chaBotsMX/chaBots-NERV-WRO-Future-Engineers-2025/v-photos/national/v-bottom.jpeg

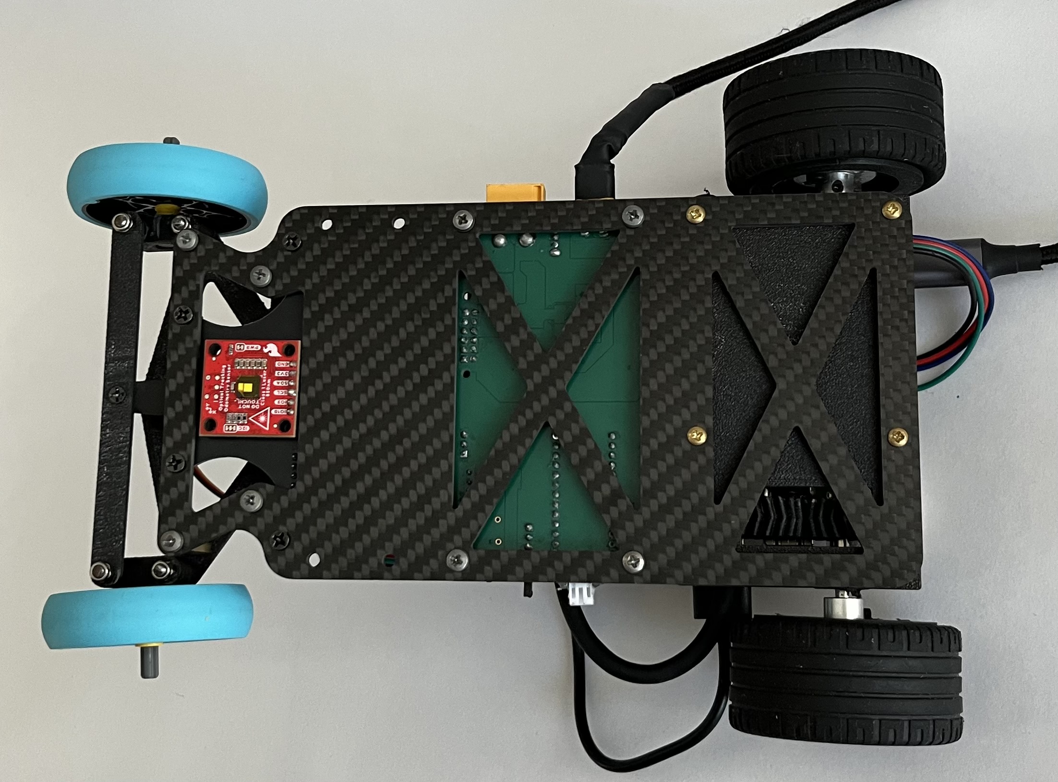
v-photos/national/v-bottom.jpeg
