chaBotsMX/chaBots-NERV-WRO-Future-Engineers-2025/v-photos/national/v-top.jpeg

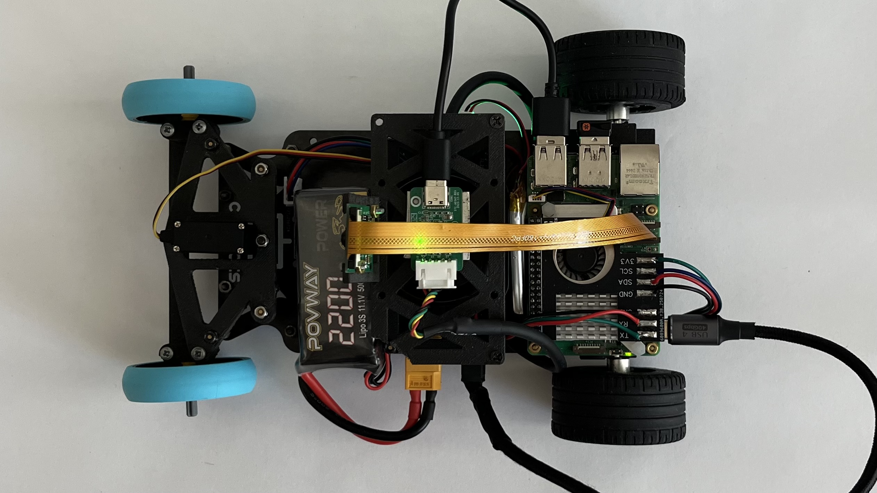
v-photos/national/v-top.jpeg
