chaBotsMX/chaBots-NERV-WRO-Future-Engineers-2025/v-photos/regional/back-view.jpeg

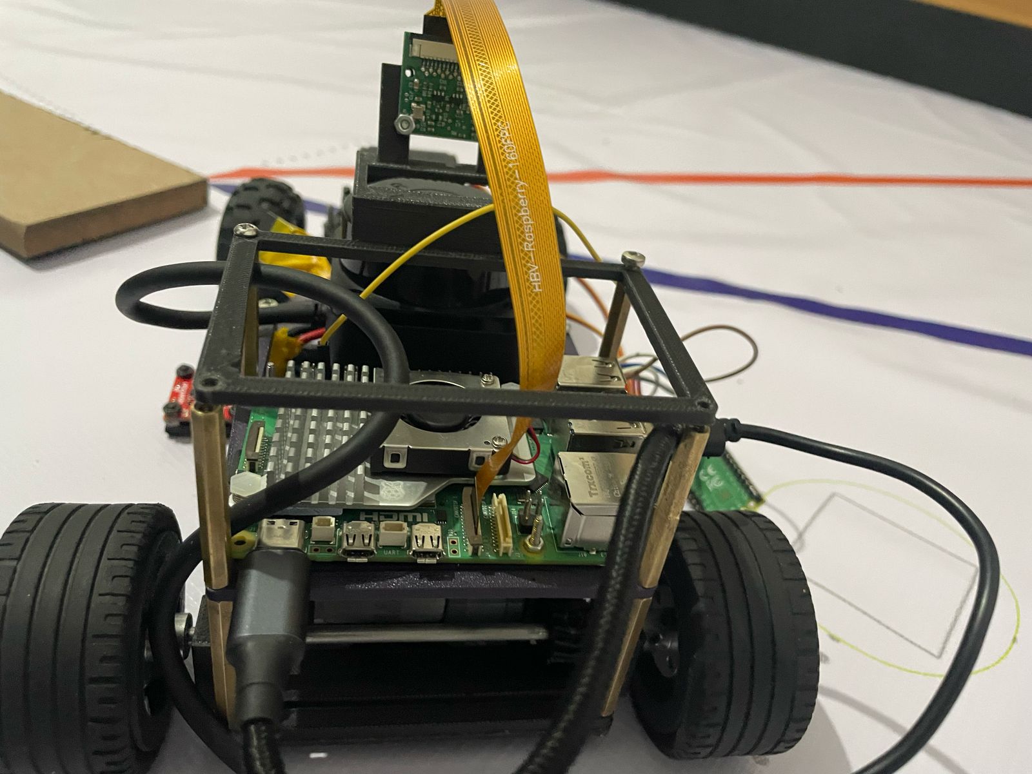
v-photos/regional/back-view.jpeg
