chaBotsMX/chaBots-NERV-WRO-Future-Engineers-2025/v-photos/regional/front-view.jpeg

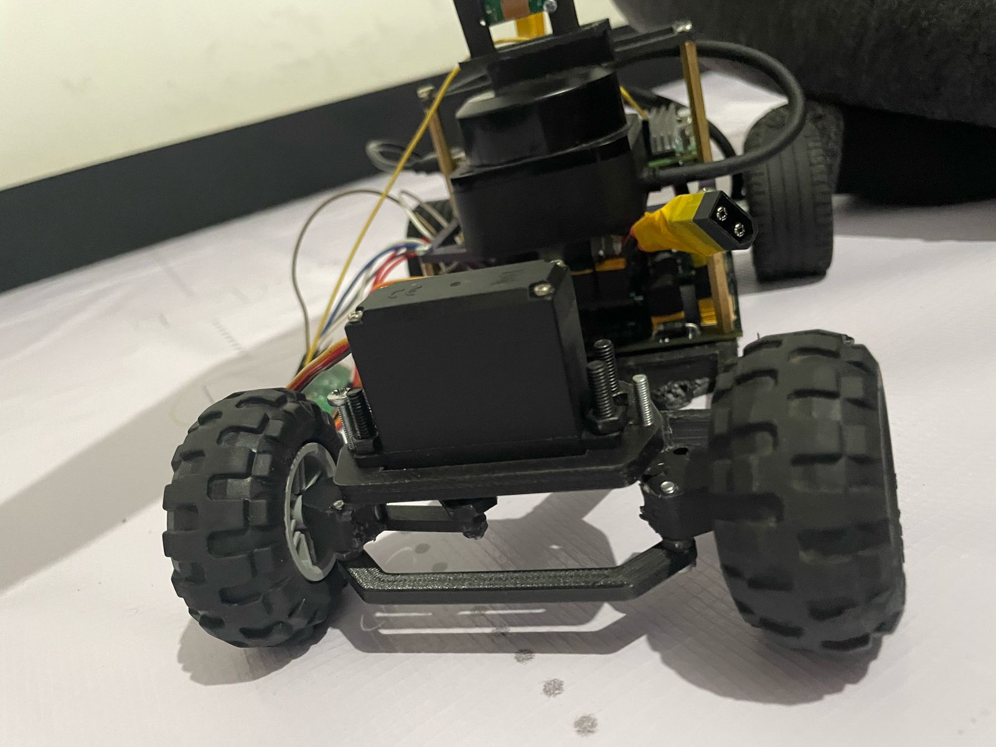
v-photos/regional/front-view.jpeg
