chaBotsMX/chaBots-NERV-WRO-Future-Engineers-2025/v-photos/regional/left-view.jpeg

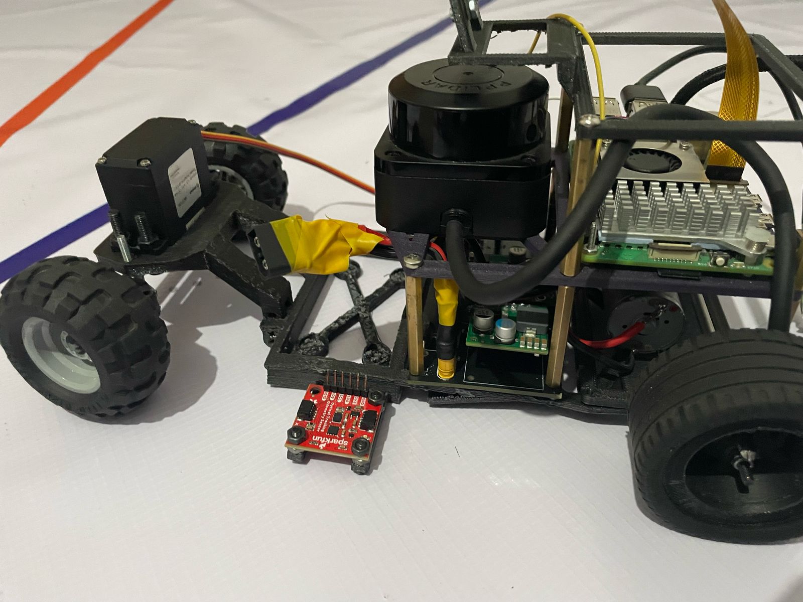
v-photos/regional/left-view.jpeg
