chaBotsMX/chaBots-NERV-WRO-Future-Engineers-2025/v-photos/regional/right-view.jpeg

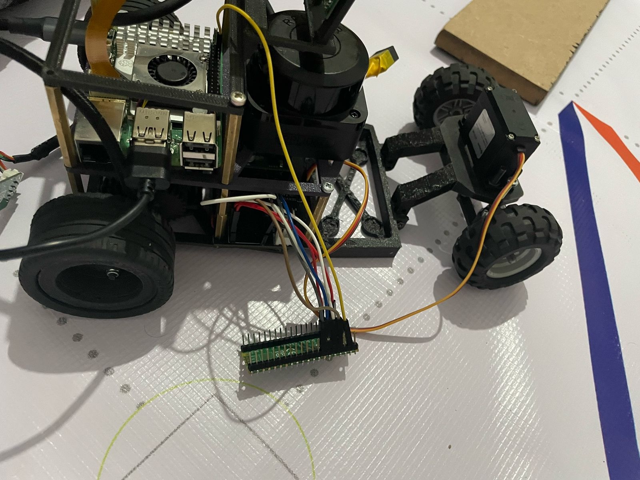
v-photos/regional/right-view.jpeg
