chaBotsMX/chaBots-NERV-WRO-Future-Engineers-2025/v-photos/regional/top-view.jpeg

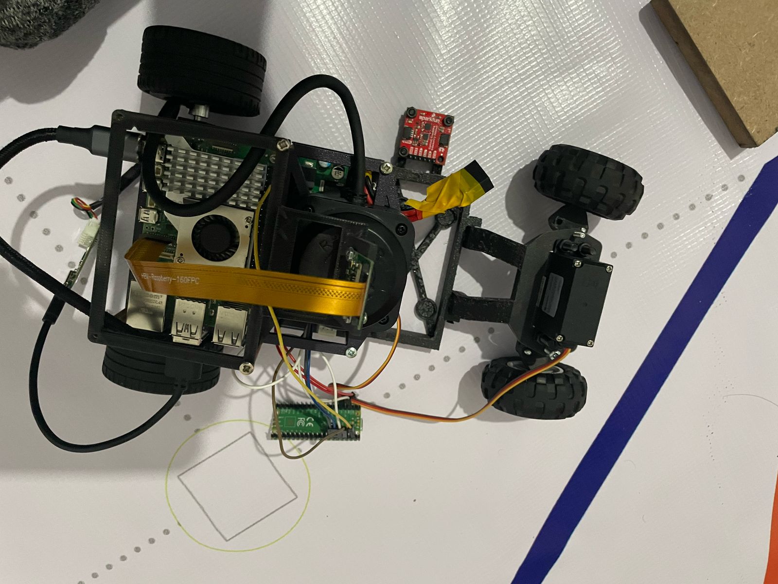
v-photos/regional/top-view.jpeg
