chaBotsMX/chaBots-NERV-WRO-Future-Engineers-2025/models/other-components/decoration-aileron.png

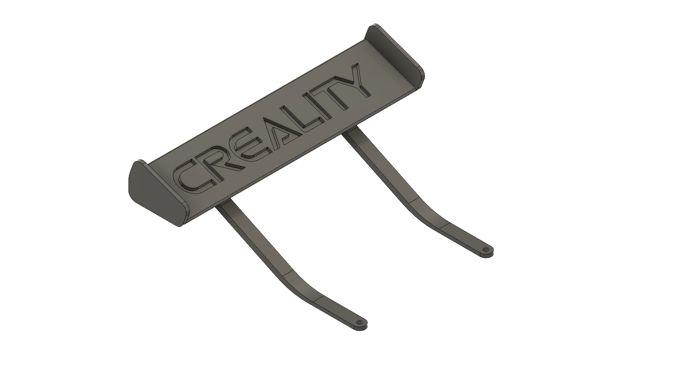
models/other-components/decoration-aileron.png
