chaBotsMX/chaBots-NERV-WRO-Future-Engineers-2025/models/other-components/railing-battery-left.png

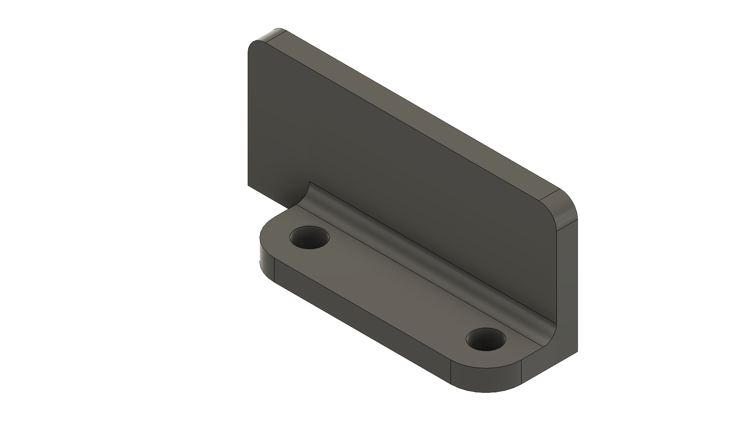
models/other-components/railing-battery-left.png
