chaBotsMX/chaBots-NERV-WRO-Future-Engineers-2025/models/other-components/railing-battery-right.png

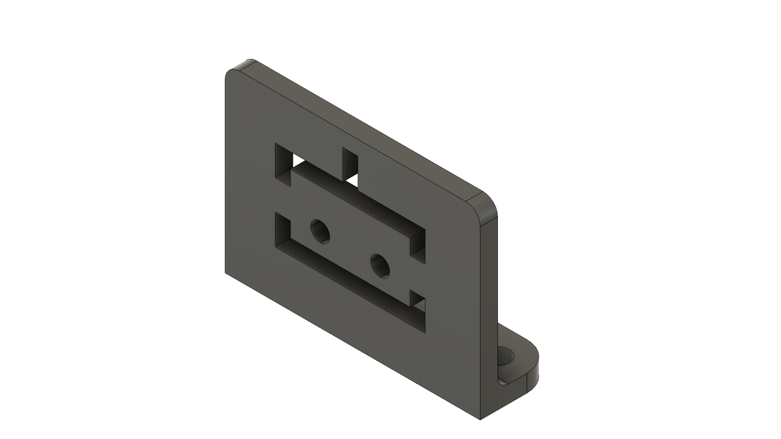
models/other-components/railing-battery-right.png
