chaBotsMX/chaBots-NERV-WRO-Future-Engineers-2025/models/gearbox/gearbox-assembly.stl

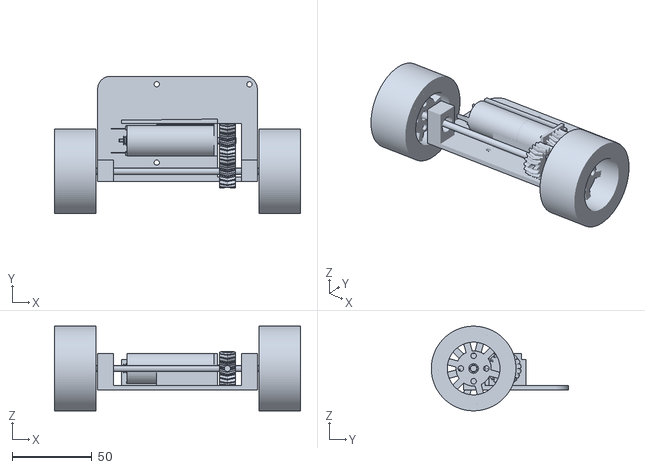
[picture p41: CAD file, 2025-11-07]
models/gearbox/gearbox-assembly.stl
154.0 x 86.0 x 53.0
