chaBotsMX/chaBots-NERV-WRO-Future-Engineers-2025/models/steering-system/steering-system-assembly.stl

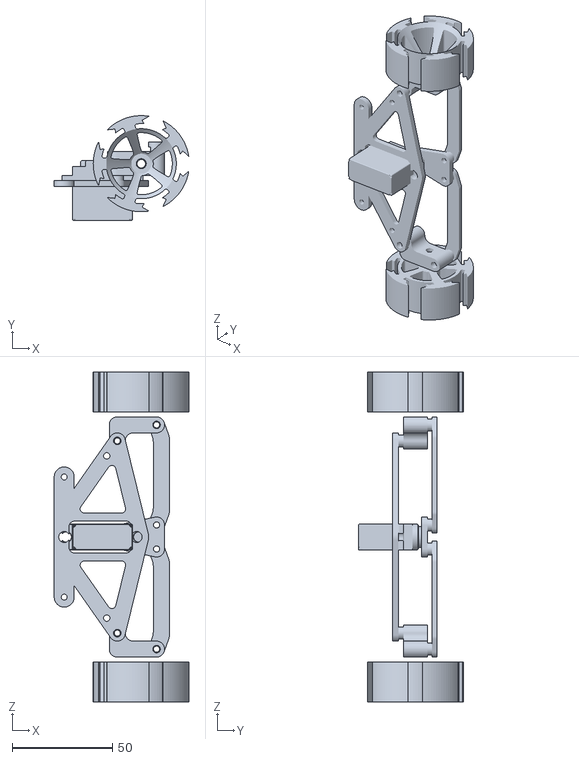
[picture p42: CAD file, 2025-11-07]
models/steering-system/steering-system-assembly.stl
67.2 x 52.3 x 164.8
