chaBotsMX/chaBots-NERV-WRO-Future-Engineers-2025/models/chassis/lidar-base.stl

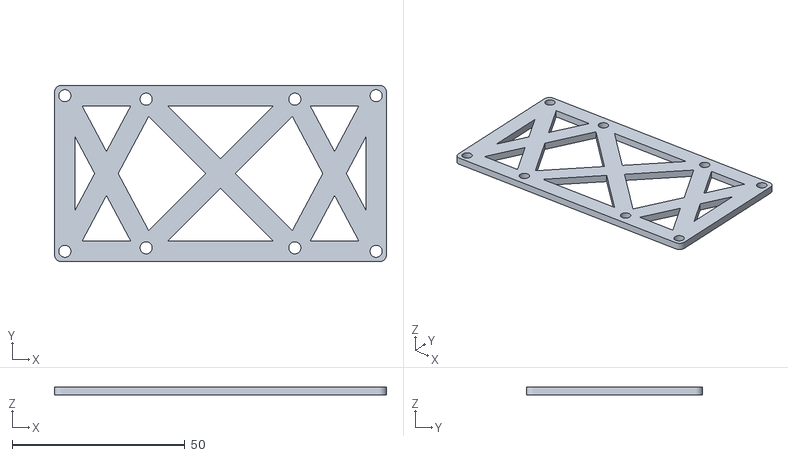
[picture p43: CAD file, 2025-08-23]
models/chassis/lidar-base.stl
96.0 x 51.0 x 2.40
