chaBotsMX/chaBots-NERV-WRO-Future-Engineers-2025/models/other-components/decoration-aileron.stl

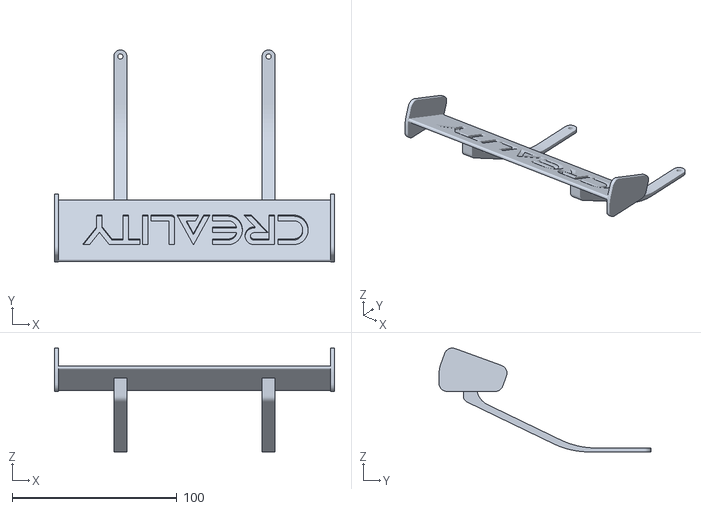
[picture p44: CAD file, 2025-11-07]
models/other-components/decoration-aileron.stl
170.0 x 128.8 x 63.1
