chaBotsMX/chaBots-NERV-WRO-Future-Engineers-2025/models/steering-system/steering-system-rhine.stl

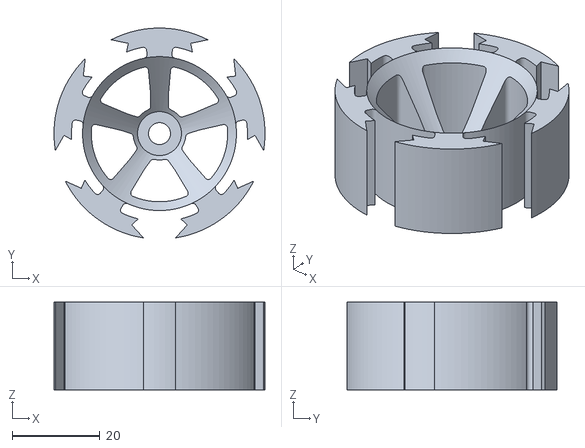
[picture p45: CAD file, 2025-11-07]
models/steering-system/steering-system-rhine.stl
48.0 x 47.7 x 20.0
