chaBotsMX/chaBots-NERV-WRO-Future-Engineers-2025/models/chassis/chassis-base.stl

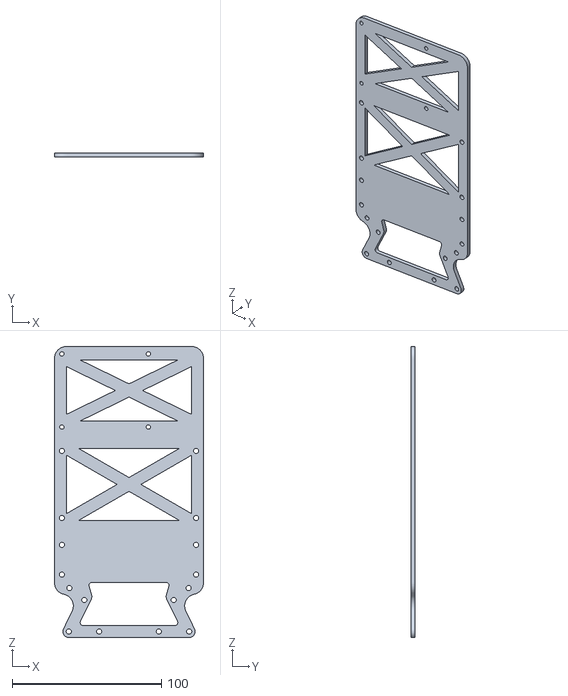
[picture p46: CAD file, 2025-08-23]
models/chassis/chassis-base.stl
100.0 x 3.00 x 195.2
