chaBotsMX/chaBots-NERV-WRO-Future-Engineers-2025/models/gearbox/gearbox-base.stl

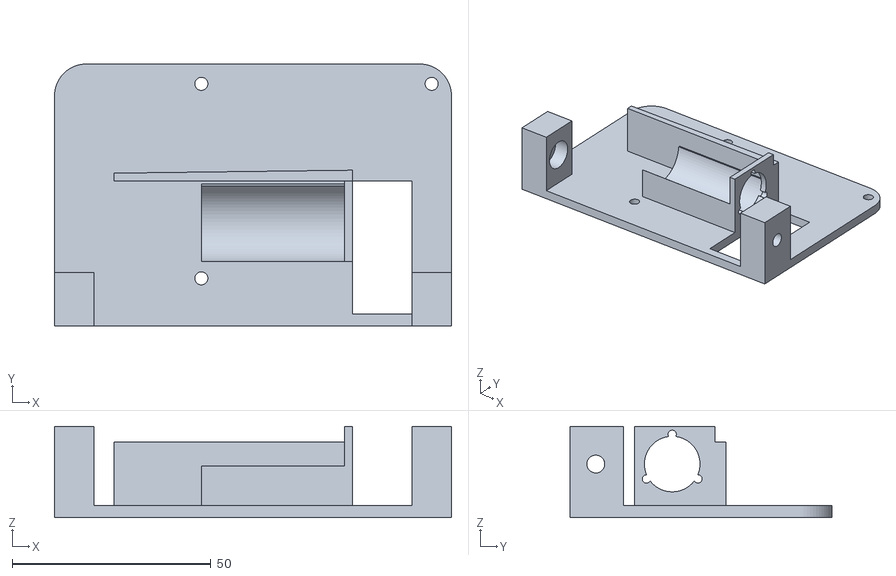
[picture p47: CAD file, 2025-11-07]
models/gearbox/gearbox-base.stl
100.0 x 66.0 x 23.0
