chaBotsMX/chaBots-NERV-WRO-Future-Engineers-2025/models/steering-system/steering-system-servoconnector.stl

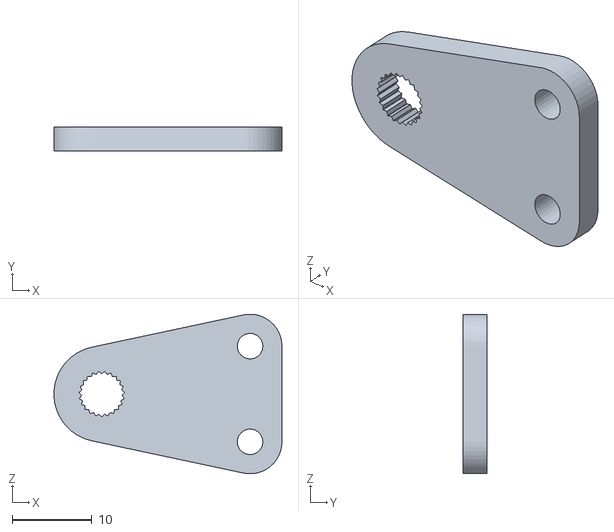
[picture p49: CAD file, 2025-11-07]
models/steering-system/steering-system-servoconnector.stl
28.6 x 3.00 x 20.0
