chaBotsMX/chaBots-NERV-WRO-Future-Engineers-2025/models/chassis/camera-base.stl

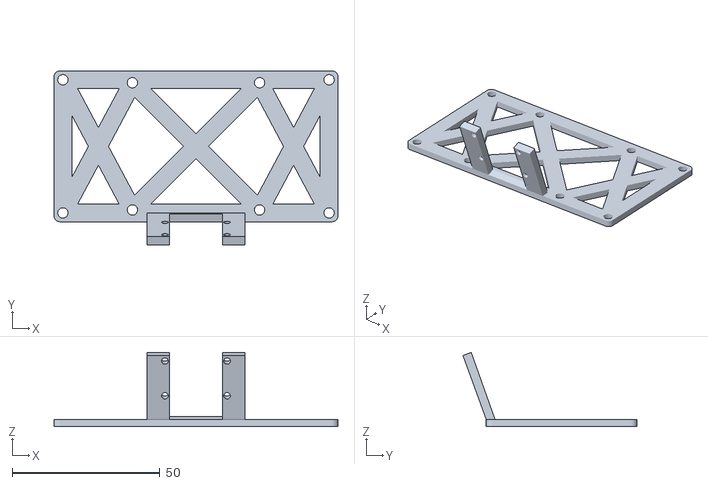
[picture p50: CAD file, 2025-08-23]
models/chassis/camera-base.stl
96.0 x 58.9 x 25.0
