chaBotsMX/chaBots-NERV-WRO-Future-Engineers-2025/models/gearbox/gearbox-MaxonDCX19.stl

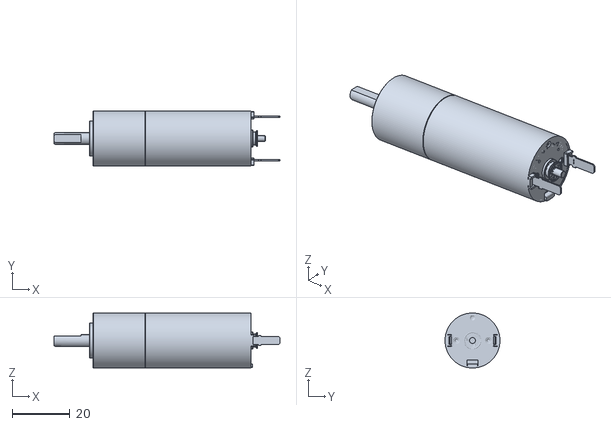
[picture p51: CAD file, 2025-11-07]
models/gearbox/gearbox-MaxonDCX19.stl
78.1 x 19.0 x 19.0
