chaBotsMX/chaBots-NERV-WRO-Future-Engineers-2025/models/other-components/railing-battery-left.stl

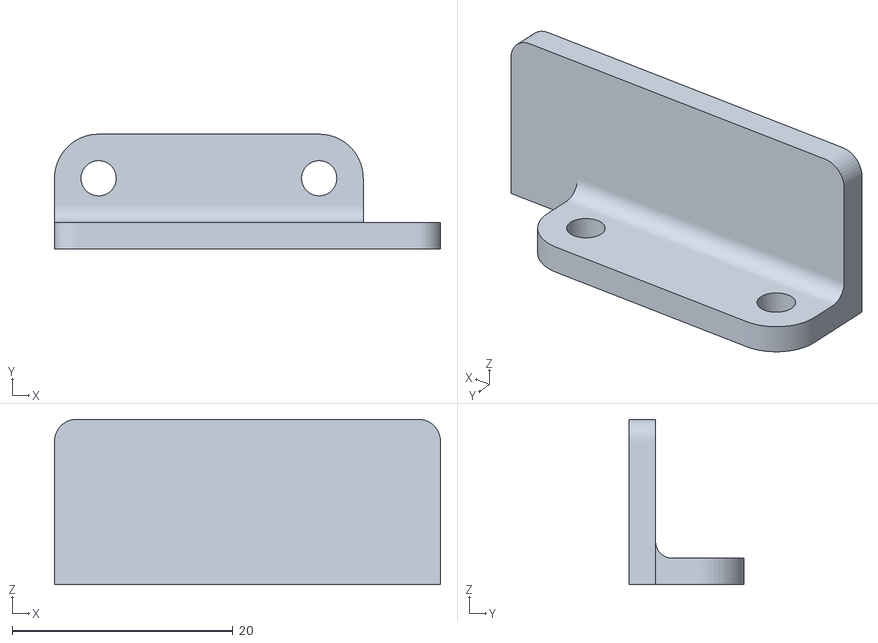
[picture p52: CAD file, 2025-11-07]
models/other-components/railing-battery-left.stl
35.0 x 10.4 x 15.0
