chaBotsMX/chaBots-NERV-WRO-Future-Engineers-2025/models/steering-system/steering-system-bracketwheel.stl

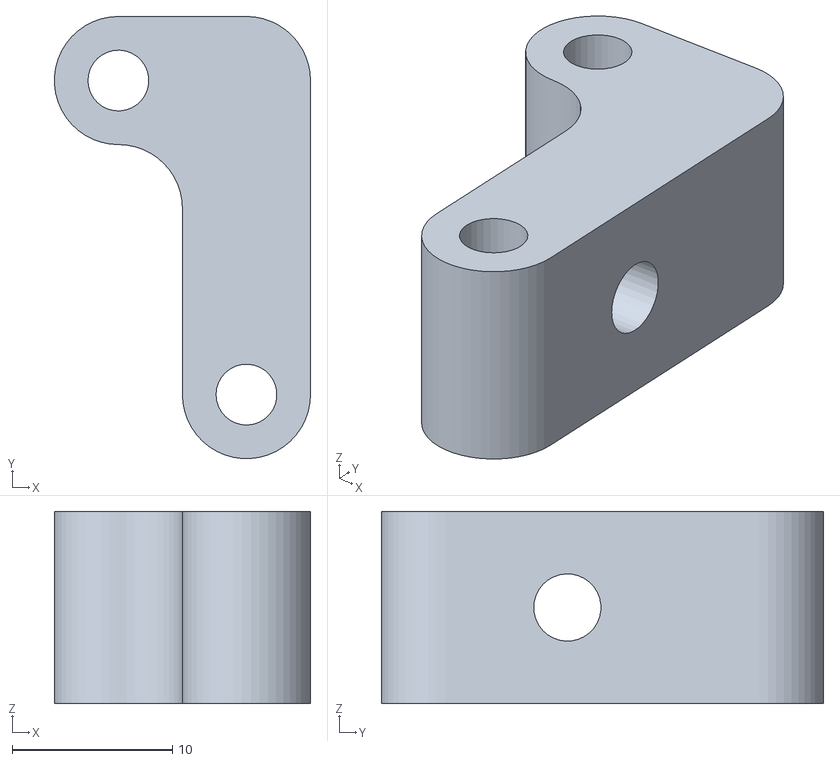
[picture p53: CAD file, 2025-11-07]
models/steering-system/steering-system-bracketwheel.stl
16.0 x 27.6 x 12.0
