chaBotsMX/chaBots-NERV-WRO-Future-Engineers-2025/models/gearbox/gearbox-rim.stl

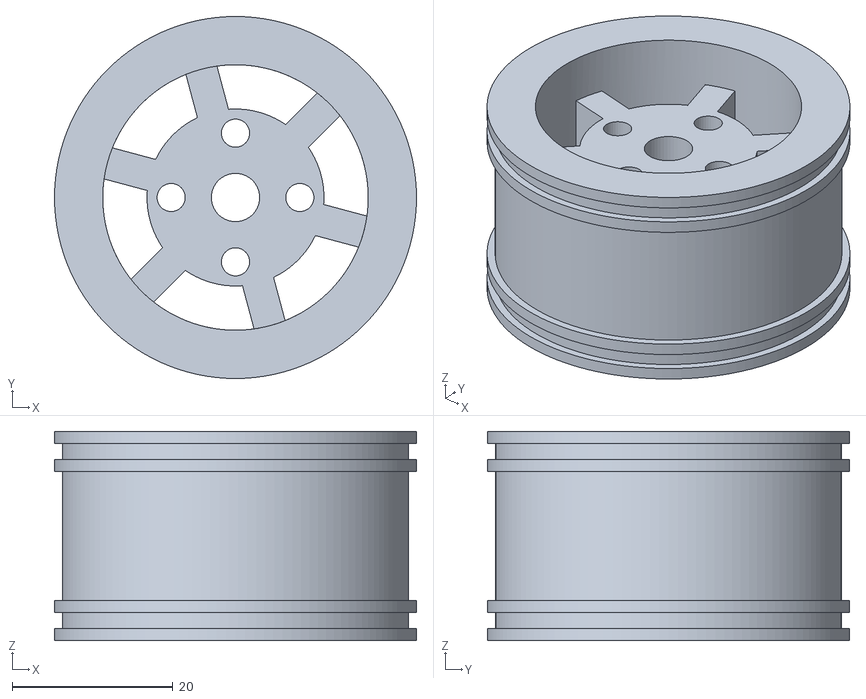
[picture p54: CAD file, 2025-11-07]
models/gearbox/gearbox-rim.stl
45.0 x 45.0 x 26.0
