chaBotsMX/chaBots-NERV-WRO-Future-Engineers-2025/models/steering-system/steering-system-base.stl

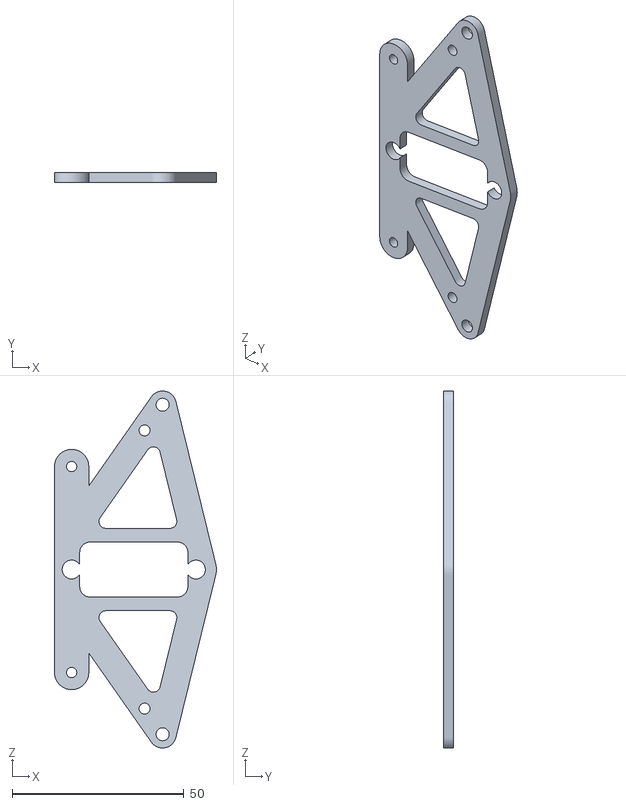
[picture p55: CAD file, 2025-11-07]
models/steering-system/steering-system-base.stl
47.2 x 3.00 x 104.0
