chaBotsMX/chaBots-NERV-WRO-Future-Engineers-2025/models/steering-system/steering-system-bracketconnector.stl

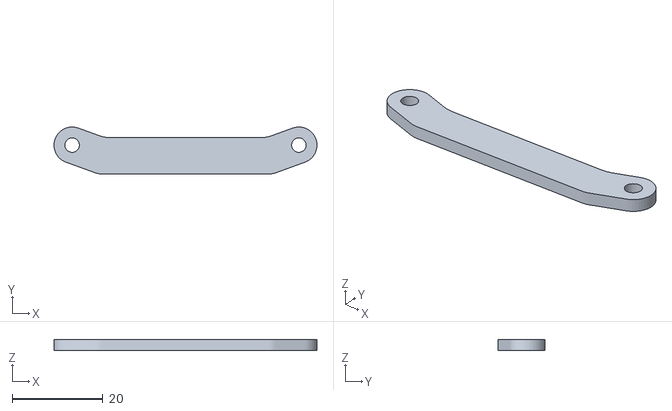
[picture p56: CAD file, 2025-11-07]
models/steering-system/steering-system-bracketconnector.stl
58.0 x 10.4 x 2.40
