chaBotsMX/chaBots-NERV-WRO-Future-Engineers-2025/models/steering-system/steering-system-HS-85MG.stl

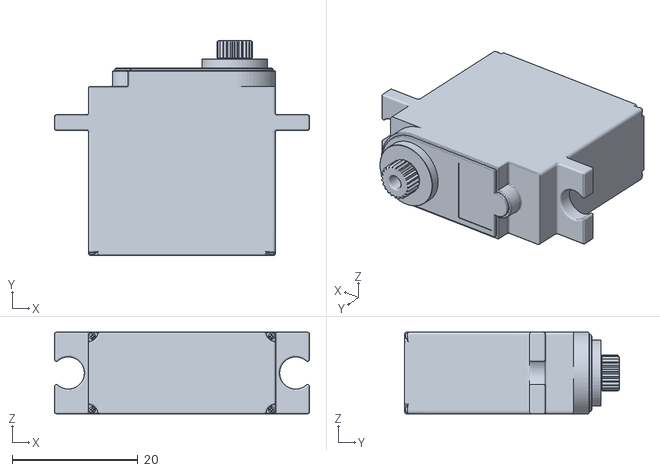
[picture p57: CAD file, 2025-11-07]
models/steering-system/steering-system-HS-85MG.stl
40.6 x 34.2 x 13.0
