chaBotsMX/chaBots-NERV-WRO-Future-Engineers-2025/schemes/sch-main.pdf

Teensy | Power Switch

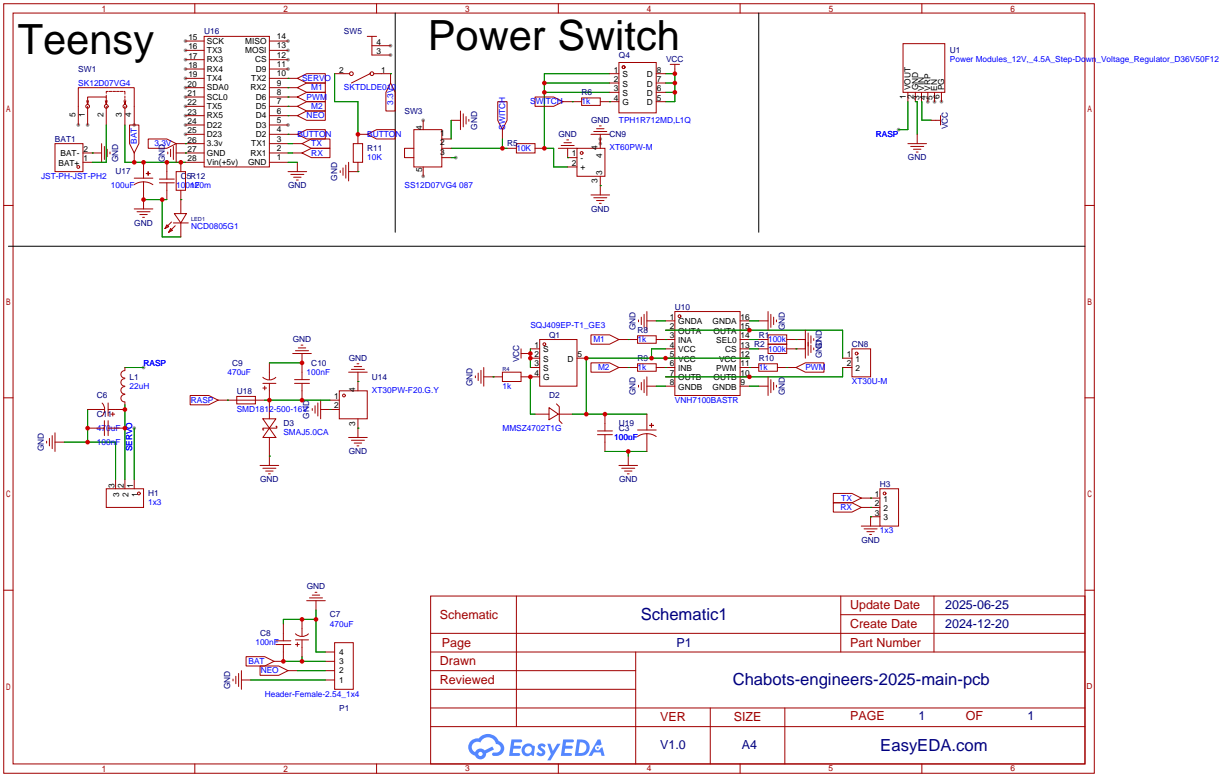
[picture p58: page 1]

OUTB 10 PWM 11 VCC 12 CS 13 SEL0 14 OUTA 15 GNDA 16
