chaBotsMX/chaBots-NERV-WRO-Future-Engineers-2025/schemes/sch-rasp.pdf

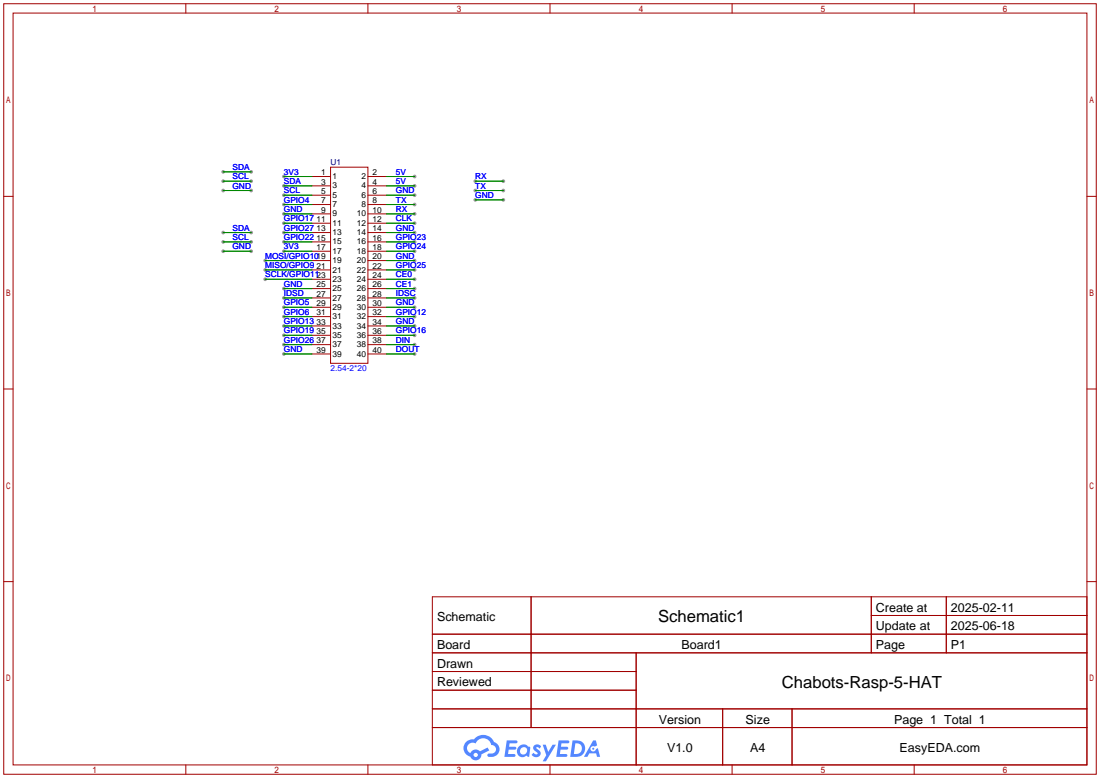
[picture p59: page 1]

Schematic | Schematic1 | Create at | 2025-02-11

Update at | 2025-06-18

Board | Board1 | Page | P1
Drawn | | Chabots-Rasp-5-HAT
Reviewed

Version | Size | Page 1 Total 1
V1.0 | A4 | EasyEDA.com
