chaBotsMX/chaBots-NERV-WRO-Future-Engineers-2025/schemes/sch-odometry.pdf

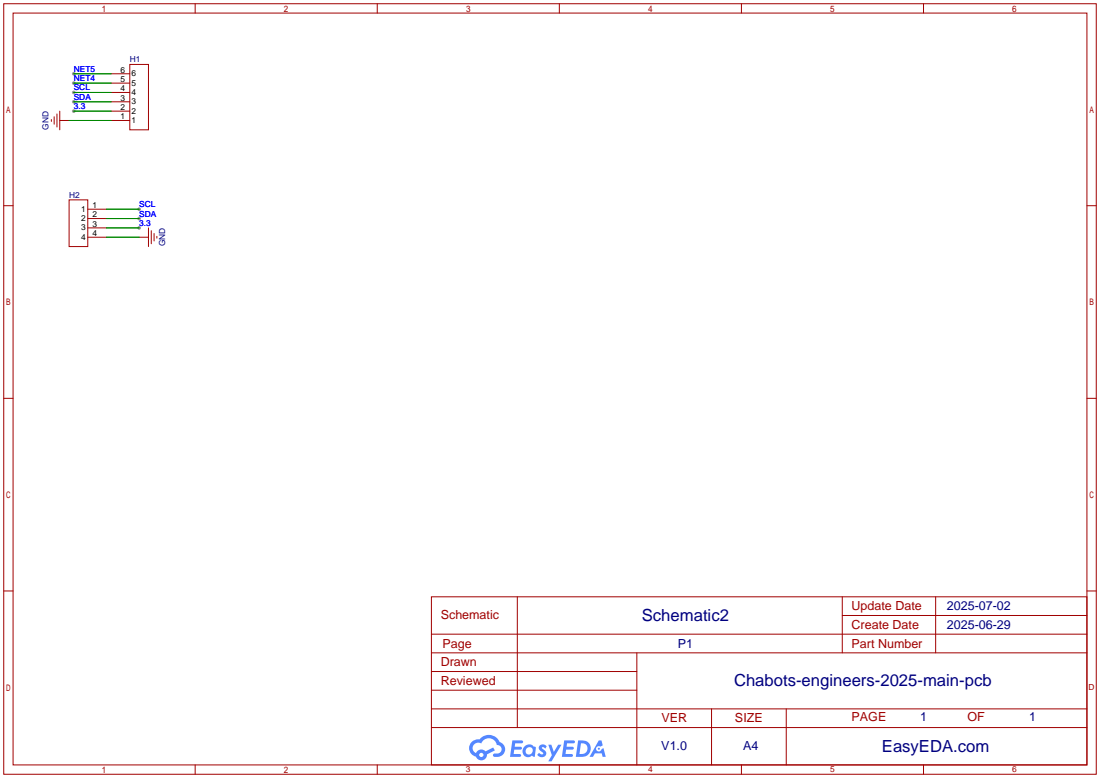
[picture p60: page 1]
