chaBotsMX/chaBots-NERV-WRO-Future-Engineers-2025/(commit log)

2025-08-13 ros ws setup
    [pyvenv.cfg]
2025-08-13 teensy node
2025-08-14 teensy main node confirm and vector sum added
2025-08-14 teensy update in serial and add more topics for foxglove debug
2025-08-14 quiic otos module bug from raspberry pi
2025-08-14 odometry fixed, bug fix urdf to use foxglove
    [robot.urdf.xacro]
2025-08-15 working code, milestone 1, first version making at least 24 constant points
    [robot.urdf, robot.urdf.xacro]
2025-08-15 LCP logic added to teensy node
2025-08-18 teensy code simplification
2025-08-22 filters added
2025-08-23 added heading to teensy communication
2025-08-23 uart fix
    [robot.urdf, robot.urdf.xacro]
2025-08-24 vision node and min changues
    [robot.urdf, robot.urdf.xacro]
2025-08-24 fix teensy and vision node
    [teensy_comm_node.cpp]
2025-08-27 added linear velocity calculation and speed based in pid from m/s
2025-08-27 fixed notadded files for last comit
    [teensy_comm_node.cpp]
2025-08-28 ACDA controller calibration
2025-08-31 update camera configuration and add vision node for color detection
2025-09-02 fixed getting oput of parking lot
    [teensy_obs_node.cpp]
2025-09-03 added pd to velocity in rect
2025-09-05 fixed and tunned tangencial kp
    [teensy_comm_node.cpp]
2025-09-06 added some logic to map track
2025-09-07 salida de estacionamineto
2025-09-09 added otos prediction, changued otos node speed to 100 samples per second, added lap wall sizes memorization, changued lidar msg to cloud point
2025-09-09 fixed histeresis, fixed declaration errors, upgrade in getvector
    [teensy_comm_node.cpp]
2025-09-11 transfer to work out of raspberry pi
2025-09-11 added logic for turn in obs round, and fixed otos calcs in open round error of using real world coordinates instead of robot base coordinates
    [teensy_obs_node.cpp]
2025-09-14 fix: update Pi Camera version and description in README
2025-09-14 fix: correct purple color detection thresholds and add noise filtering
2025-09-14 fix: restore green color detection thresholds and add noise filtering for green and red
2025-09-16 added yaw to trayectory calcs in open round
2025-09-16 code clean up
    [pyvenv.cfg]
2025-09-16 Update README.md: Revise camera version, add construction tools, and update cost report
2025-09-16 Update README.md: Revise section titles and sensor descriptions
2025-09-17 Add obstacle avoidance system documentation with multi-sensor integration details
2025-10-28 steering system update
    [BrandalPilaR v6.f3d, steering-system-assembly.stl, steering-system-base.stl, steering-system-bracketconnector.stl, steering-system-bracketwheel.stl, steering-system-bracketwheels.stl, steering-system-rhine.stl, steering-system-servoconnector.stl]
2025-11-07 Refactor README.md to enhance table formatting and improve content presentation for the steering system and chassis sections.
2025-11-07 Update README.md to standardize image sizes for better visual consistency across gearbox and steering system sections.
2025-11-07 Refactor README.md to improve table formatting and enhance content clarity in the gearbox and steering system sections, including updates to image presentation and descriptions.
2025-11-07 Update README.md to enhance image links for the servo and base sections, ensuring proper display and maintaining content clarity.
2025-11-07 Refactor README.md to improve table formatting and enhance content clarity in the servo and base sections, including updates to image presentation.
2025-11-08 Refactor README.md to enhance table formatting and improve image presentation for the gearbox section, ensuring consistent styling and layout.
2025-11-08 Update README.md to standardize image sizes in the gearbox section for improved visual consistency.
2025-11-08 Fix image URLs in README.md for gearbox section to ensure proper display.
2025-11-08 Update image sizes in README.md for gearbox section to enhance visual consistency.
2025-11-08 Update image attributes in README.md for gearbox section to standardize dimensions and improve layout consistency.
2025-11-08 Refactor gearbox section in README.md to use a table format for improved clarity and presentation of gear descriptions and images.
2025-11-08 Update gearbox section in README.md to enhance gear image size for better visibility and detail.
2025-11-08 Refactor gearbox section in README.md to use a table format for gear descriptions and images, enhancing clarity and visual consistency.
2025-11-08 Update image attributes in README.md for gearbox section to enhance descriptions and improve visual consistency.
2025-11-08 Update gearbox and steering system sections in README.md to center images and enhance visual presentation
2025-11-08 Refactor gearbox and steering system sections in README.md to use table format for improved clarity and visual consistency of descriptions and images.
2025-11-08 Refactor gearbox and steering system sections in README.md to use markdown tables for improved clarity and visual consistency of descriptions and images.
2025-11-08 Update image attributes in README.md for steering system section to enhance visual consistency and presentation.
2025-11-08 Update image attributes in README.md for steering system base to enhance formatting and visual consistency.
2025-11-08 Refactor image attributes in README.md to use <picture> tags for improved accessibility and visual consistency in gearbox and steering system sections.
2025-11-08 Refactor image attributes in README.md to enhance formatting and visual consistency using <picture> tags for improved presentation in gearbox and steering system sections.
2025-11-08 Update image attributes in README.md to enhance visual consistency by applying style attributes for improved presentation in gearbox and steering system sections.
2025-11-08 Update image attributes in README.md for lidar and camera bases to enhance visual consistency by removing <picture> tags.
2025-11-08 Update image attributes in README.md for lidar and camera bases to enhance visual consistency by standardizing table formatting.
2025-11-08 Refactor image attributes in README.md for lidar and camera bases to enhance visual consistency by removing inline style attributes.
2025-11-08 Revise gearbox and steering system documentation
    Updated the README to enhance the gearbox and steering system sections, including detailed descriptions and images for various components.
2025-11-08 Add detailed documentation for open source ROS2 packages and sensor integration
2025-11-08 Enhance README with detailed flow diagrams and implementation details for Open Round and Obstacle Round control systems
